xmoshte/nielo/docs/pics&3d/nielo_fv.png

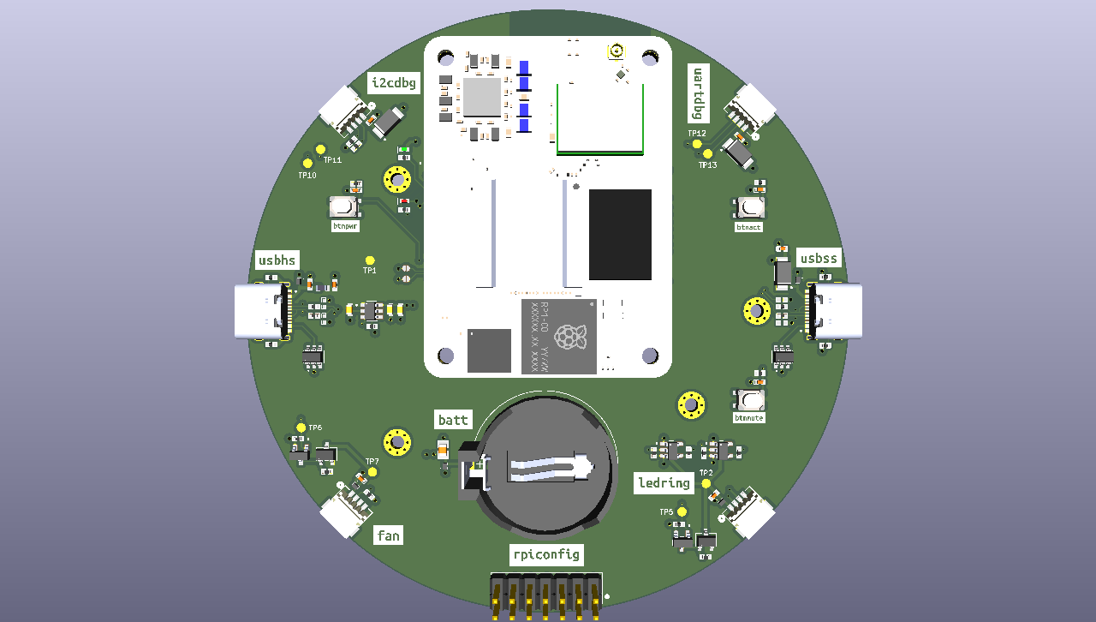
docs/pics&3d/nielo_fv.png
