xmoshte/nielo/docs/pics&3d/nielo_bv.png

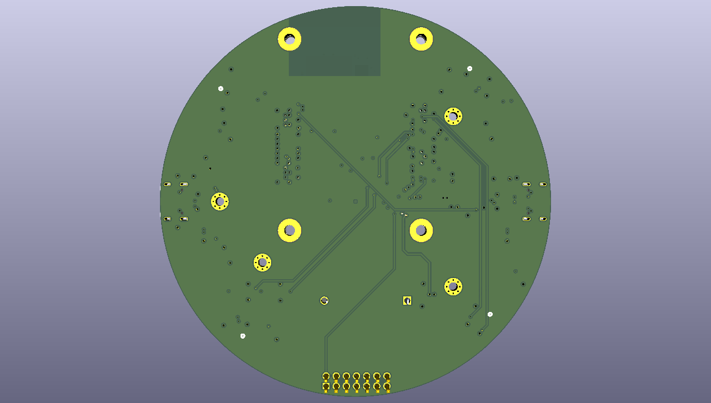
docs/pics&3d/nielo_bv.png
