xmoshte/nielo/docs/pics&3d/nielo.step

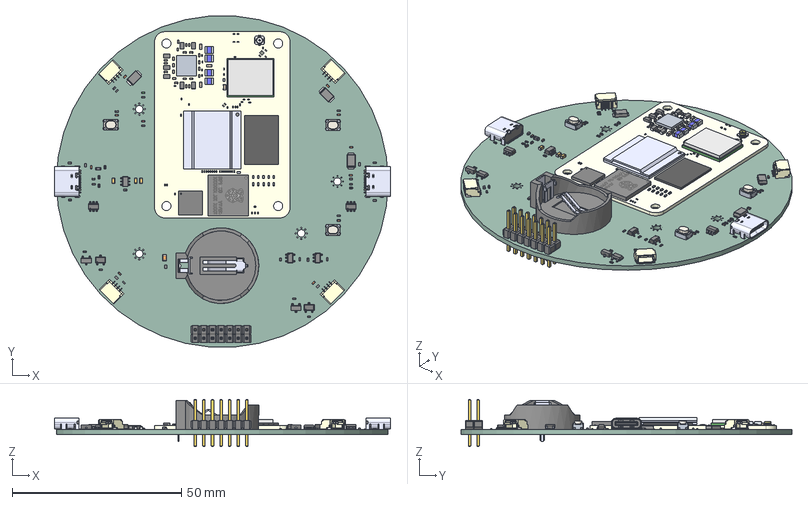
[picture p3: CAD file, 2026-09-26]
docs/pics&3d/nielo.step
99.3 x 97.7 x 14.0 mm
User Library-0402(1005M) Cap x 14
PESD5V5C1BLYL x 5
User Library-res0402-1 x 25
TYPE-C-31-M-12 x 2
PTS815SJM250SMTRLFS_PART1 x 3
PTS815SJM250SMTRLFS_PART2 x 3
PTS815SJM250SMTRLFS_PART3_2 x 3
PTS815SJM250SMTRLFS_PART3 x 3
PTS815SJM250SMTRLFS_PART3_1 x 3
PTS815SJM250SMTRLFS_PART3_4 x 3
PTS815SJM250SMTRLFS_PART3_3 x 3
200-ball_VFBGAold.step
CAP0201.step x 190
RES0201old.step x 71
CAP0402.step x 81
PMIC STEP.STEP
3D-SRP201208-R47MH-20230512 .step x 7
term2 x 4
term1 x 4
2712 v2 STEP.STEP
CAP0603.step x 10
RES0402.step x 10
SOT883B Mold body x 4
SOT883B4 LF x 4
User Library-SKY13351-378LF.step
ProjectY v3 STEP.STEP
(Unsaved)
PinIndicator
Pads x 2
Lid x 2
Plating
LDF
CPD
Pins
User Library-153BallWFBGA
10164228-1001A1RLF.stp x 2
ABM11-0022-T3.step x 2
DIELECTRIC_Model_1_Inst
User Library-Chip Capacitor2 x 3
SM04B-SRSS-TB(LF)(SN) x 4
User Library-led_0402 x 2
2N7002_2N7002 x 2
SMA6S56AH MWG x 3
DBV5 x 2
BS-7
SW3dPS-0805 SMD Capacitor
AP22653W6-7
nie1CBC_PCB
