xmoshte/nielo/docs/schematics/nielo.pdf

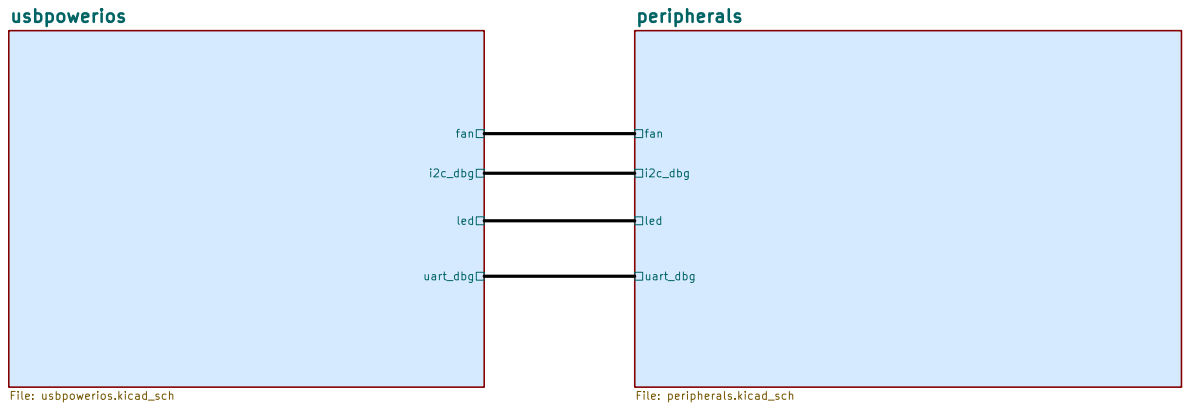
[picture p4: page 1]

Size: A4 | Rev:
KiCad E.D.A. 10.0.5 | Id: 1/3

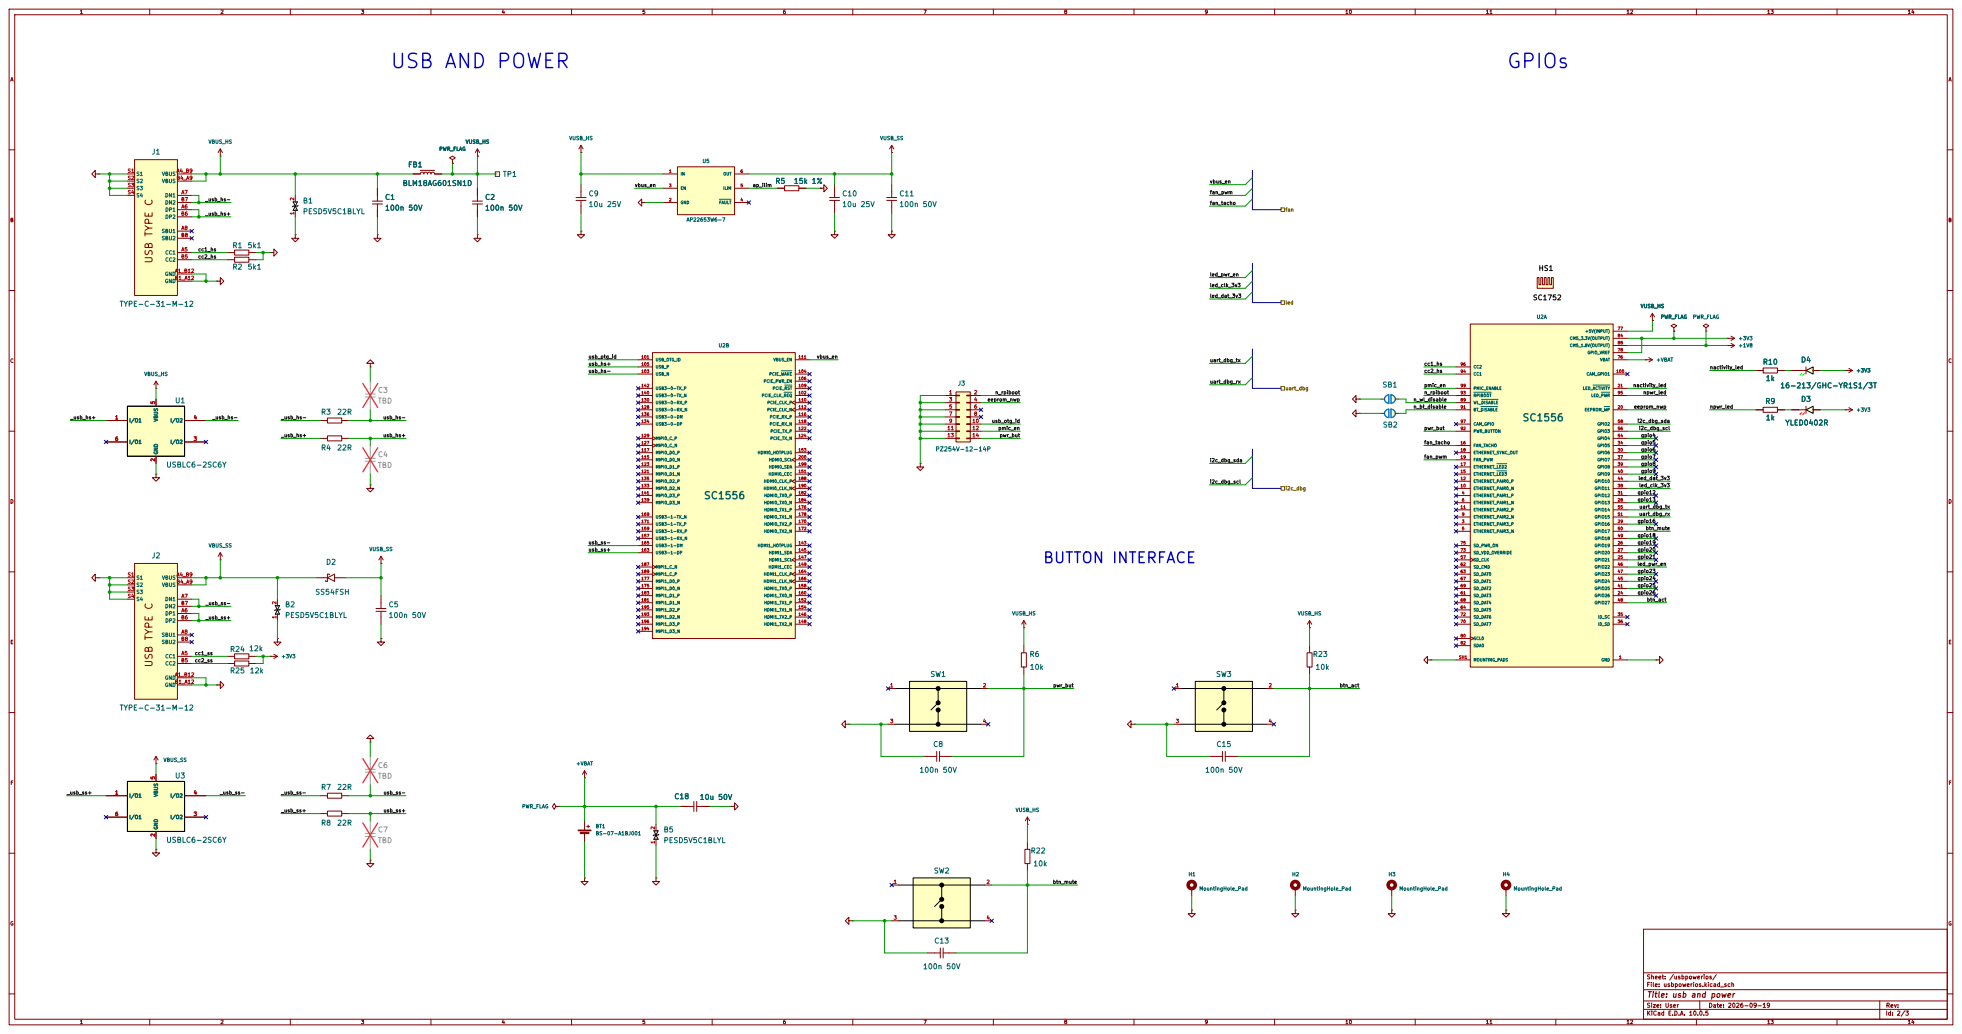
[picture p5: page 2]

11 | 12 pmic_en
13 | 14

Sheet: /usbpowerios/
File: usbpowerios.kicad_sch
Title: usb and power

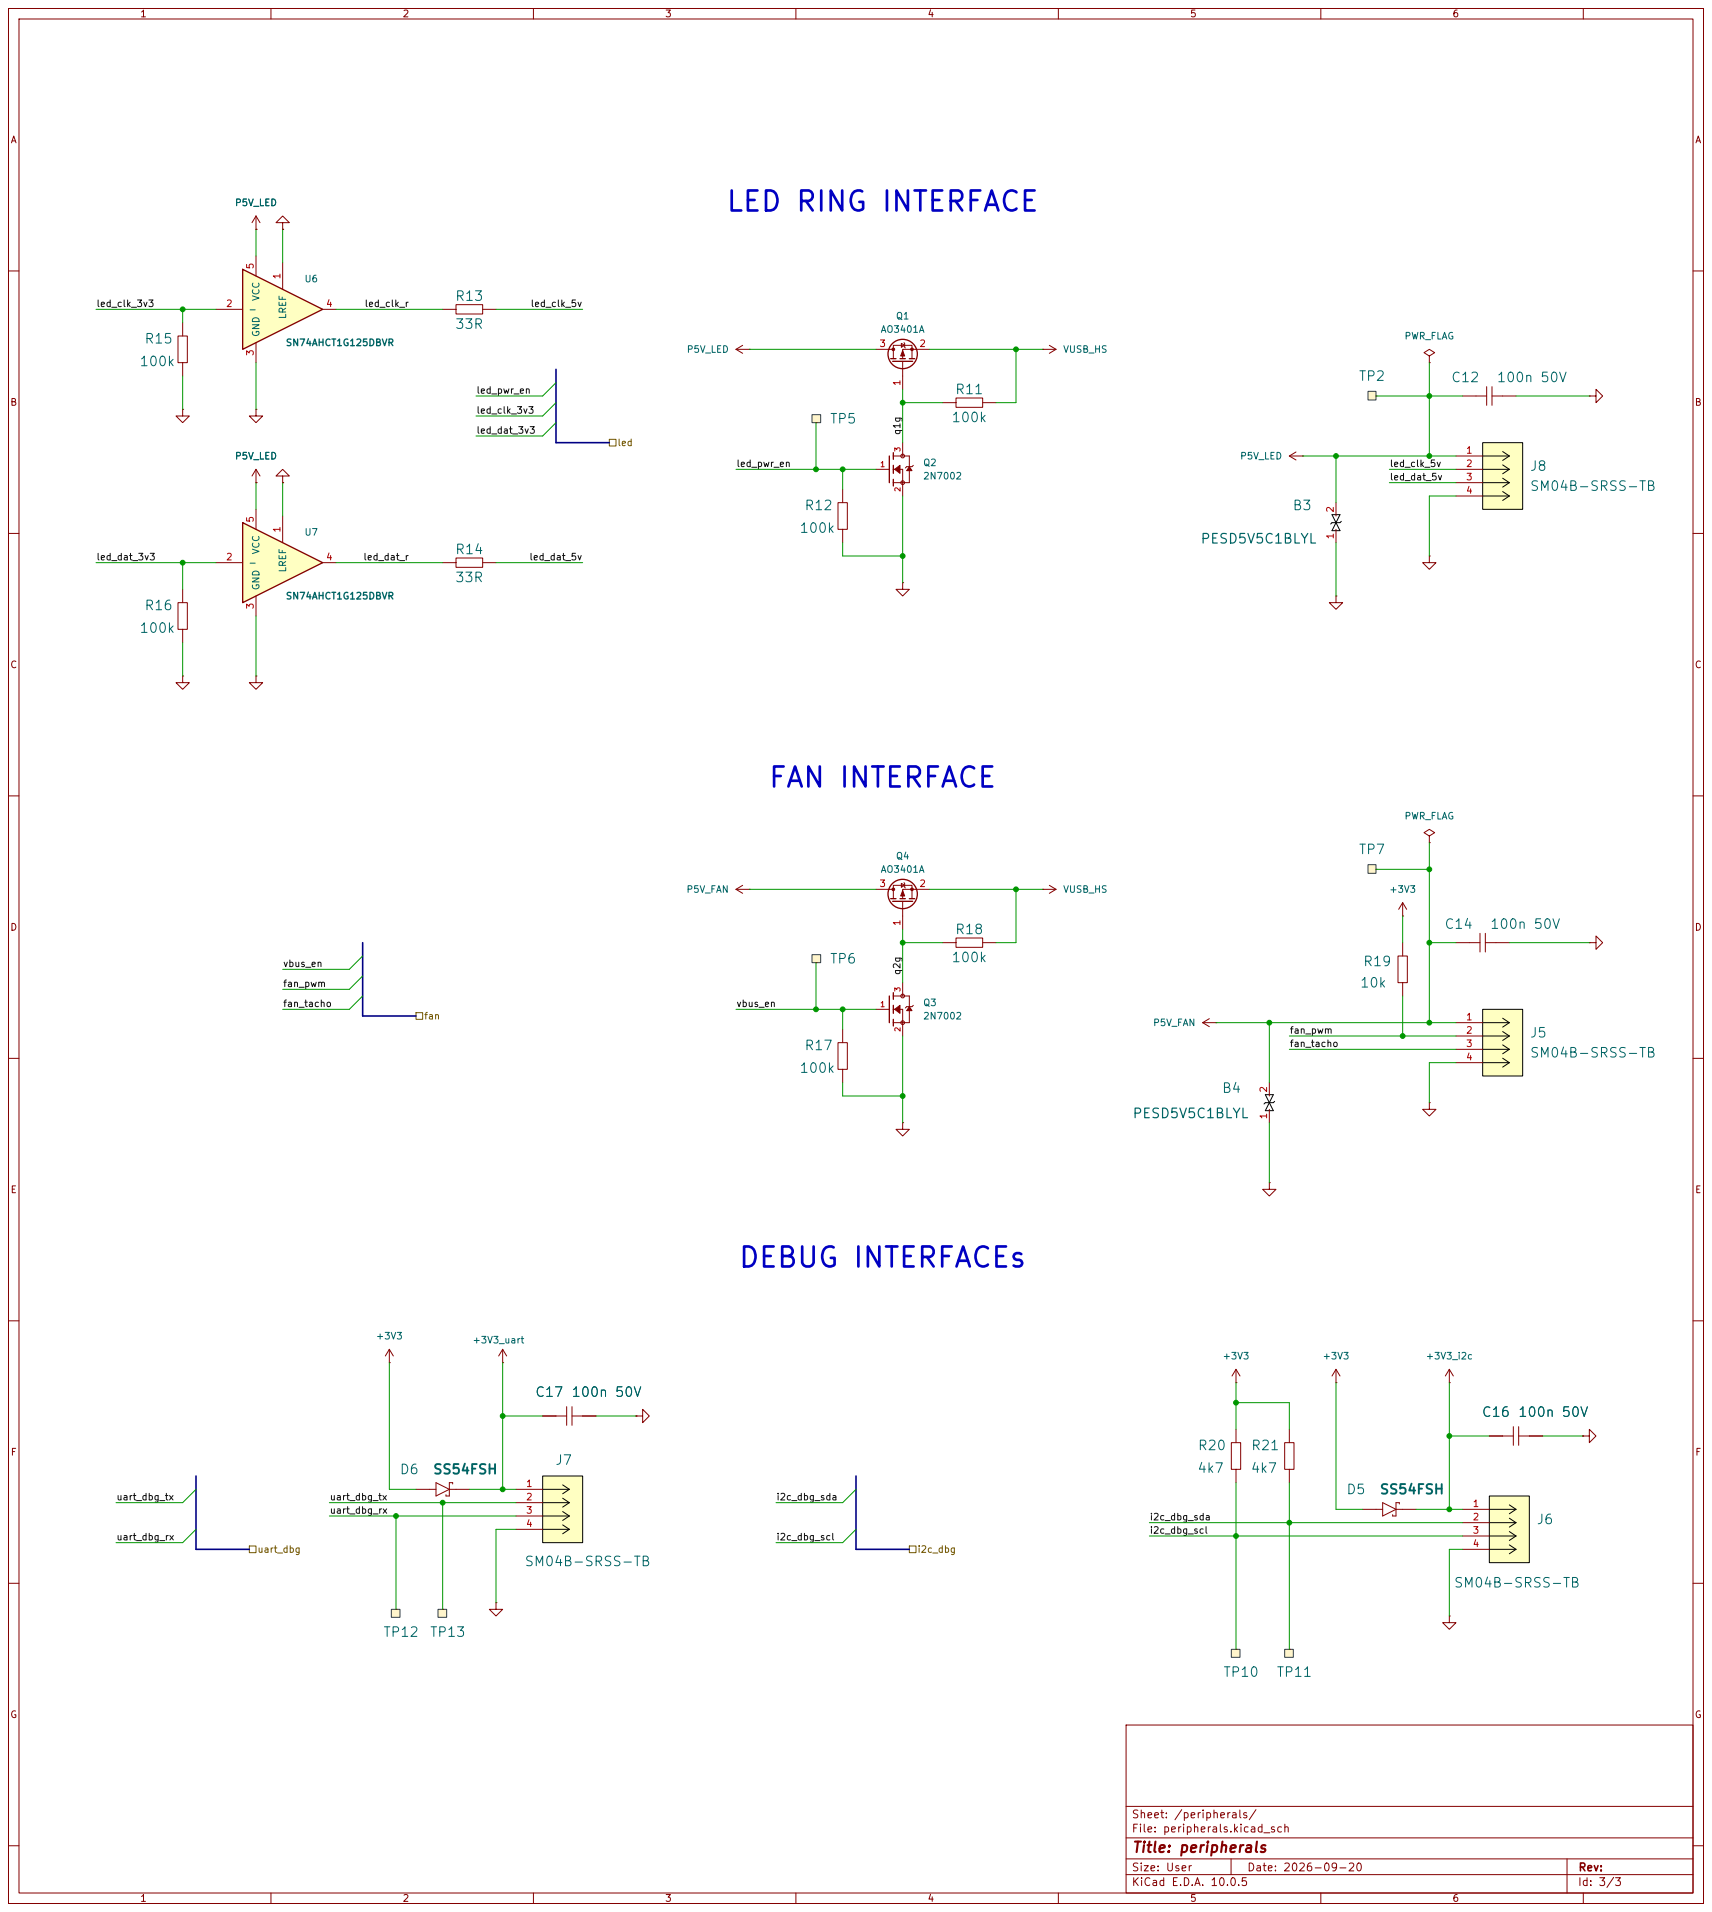
[picture p6: page 3]
