xmoshte/nielo/source/nielo.kicad_pcb

## KiCad design source/nielo.kicad_pcb (2026-09-26)

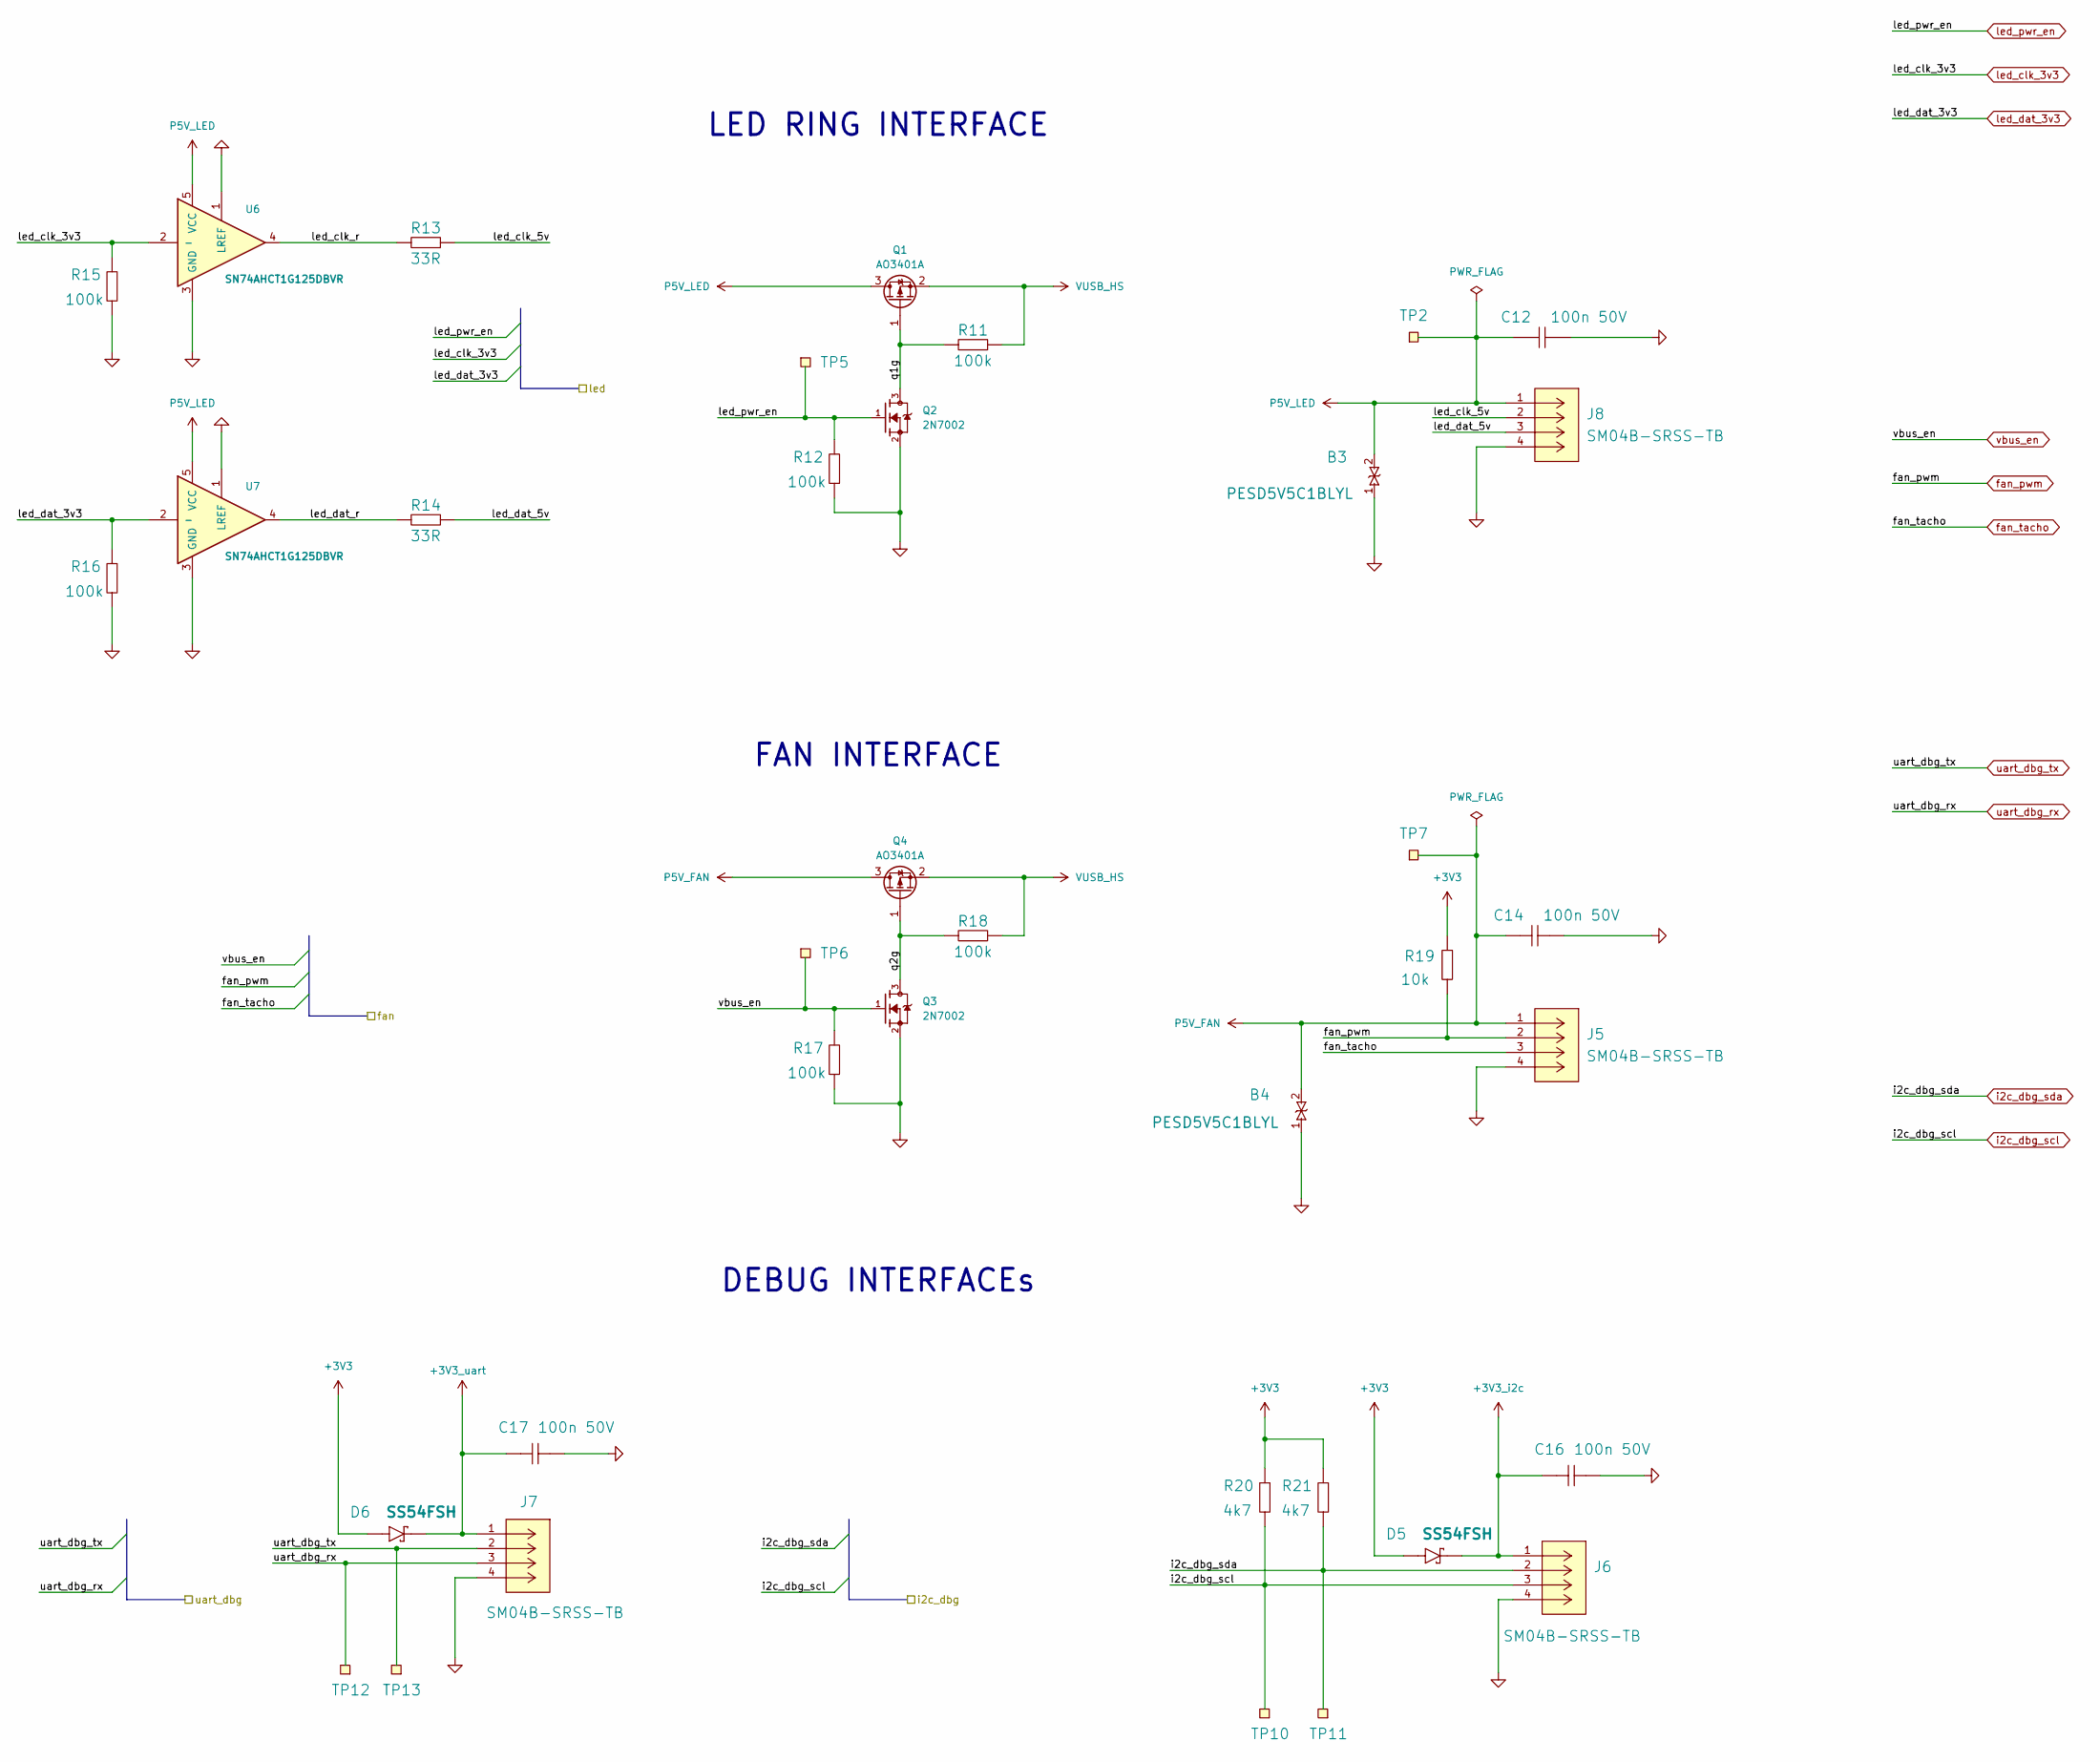
[picture p7: schematic peripherals.kicad_sch]

Parts:
B3, B4: PESD5V5C1BLYL; MPN PESD5V5C1BLYL; LCSC No C18212174
C12, C14, C16, C17: 100n 50V; CAPC1005X04L; MPN 04025C104JAT2A; DigiKey No 478-KGM05CR71H104JHTR-ND
D5, D6: SS54FSH; SODFL4725X110N; MPN SS54FSH; LCSC No C19855357
J5, J6, J7, J8: SM04B-SRSS-TB; CONN_SM04B-SRSS-TB_JST; MPN SM04B-SRSS-TB; Mouser No 306-SM04BSRSSTBLFSN
Q1, Q4: AO3401A; SOT-23-3L_AOS; MPN AO3401A; DigiKey No 785-1001-2-ND
Q2, Q3: 2N7002; SOT95P240X111-3N; MPN 2N7002; Mouser No 512-2N7002
R11, R12, R15, R16, R17, R18: 100k; RESC1005X04L; MPN CR0402-JW-104GLF; LCSC No C203104
R13, R14: 33R; RESC1005X04L; MPN MCS0402MC3309FE000; LCSC No C2074234
R19: 10k; RESC1005X04L; MPN MCS0402MD1002BE500; LCSC No C2073498
R20, R21: 4k7; RESC1005X04L; MPN RCA04024K70FKED; LCSC No C1858949
TP2, TP5, TP6, TP7, TP10, TP11, TP12, TP13: TP_SMD_D1.5mm
U6, U7: SN74AHCT1G125DBVR; SOT95P280X145-5N; MPN SN74AHCT1G125DBVR; Mouser No 595-SNAHCT1G125DBVR

Connections:
+3V3: D5.A, D6.A, R19.2, R20.2, R21.2; also elsewhere on the board
+3V3_i2c: C16.2, D5.C (K), J6.1
+3V3_uart: C17.2, D6.C (K), J7.1
/peripherals/led_clk_5v: J8.2, R13.2
/peripherals/led_clk_r: R13.1, U6.4
/peripherals/led_dat_5v: J8.3, R14.2
/peripherals/led_dat_r: R14.1, U7.4
/peripherals/q1g: Q1.1 (G), Q2.3, R11.1
/peripherals/q2g: Q3.3, Q4.1 (G), R18.1
GND: B3.1 (K1), B4.1 (K1), C12.1, C14.1, C16.1, C17.1, J5.4, J6.4, J7.4, J8.4, Q2.2, Q3.2, R12.1, R15.1, R16.1, R17.1, U6.1 (LREF), U6.3 (GND), U7.1 (LREF), U7.3 (GND); also elsewhere on the board
P5V_FAN: B4.2 (K2), C14.2, J5.1, Q4.3 (D), TP7.1 (1_1)
P5V_LED: B3.2 (K2), C12.2, J8.1, Q1.3 (D), TP2.1 (1_1), U6.5 (VCC), U7.5 (VCC)
VUSB_HS: Q1.2 (S), Q4.2 (S), R11.2, R18.2; also elsewhere on the board
fan_pwm: J5.2, R19.1; also elsewhere on the board
fan_tacho: J5.3; also elsewhere on the board
i2c_dbg_scl: J6.3, R20.1, TP10.1 (1_1); also elsewhere on the board
i2c_dbg_sda: J6.2, R21.1, TP11.1 (1_1); also elsewhere on the board
led_clk_3v3: R15.2, U6.2 (-); also elsewhere on the board
led_dat_3v3: R16.2, U7.2 (-); also elsewhere on the board
led_pwr_en: Q2.1, R12.2, TP5.1 (1_1); also elsewhere on the board
uart_dbg_rx: J7.3, TP12.1 (1_1); also elsewhere on the board
uart_dbg_tx: J7.2, TP13.1 (1_1); also elsewhere on the board
vbus_en: Q3.1, R17.2, TP6.1 (1_1); also elsewhere on the board

Notes on the sheet:
LED RING INTERFACE
DEBUG INTERFACEs
FAN INTERFACE

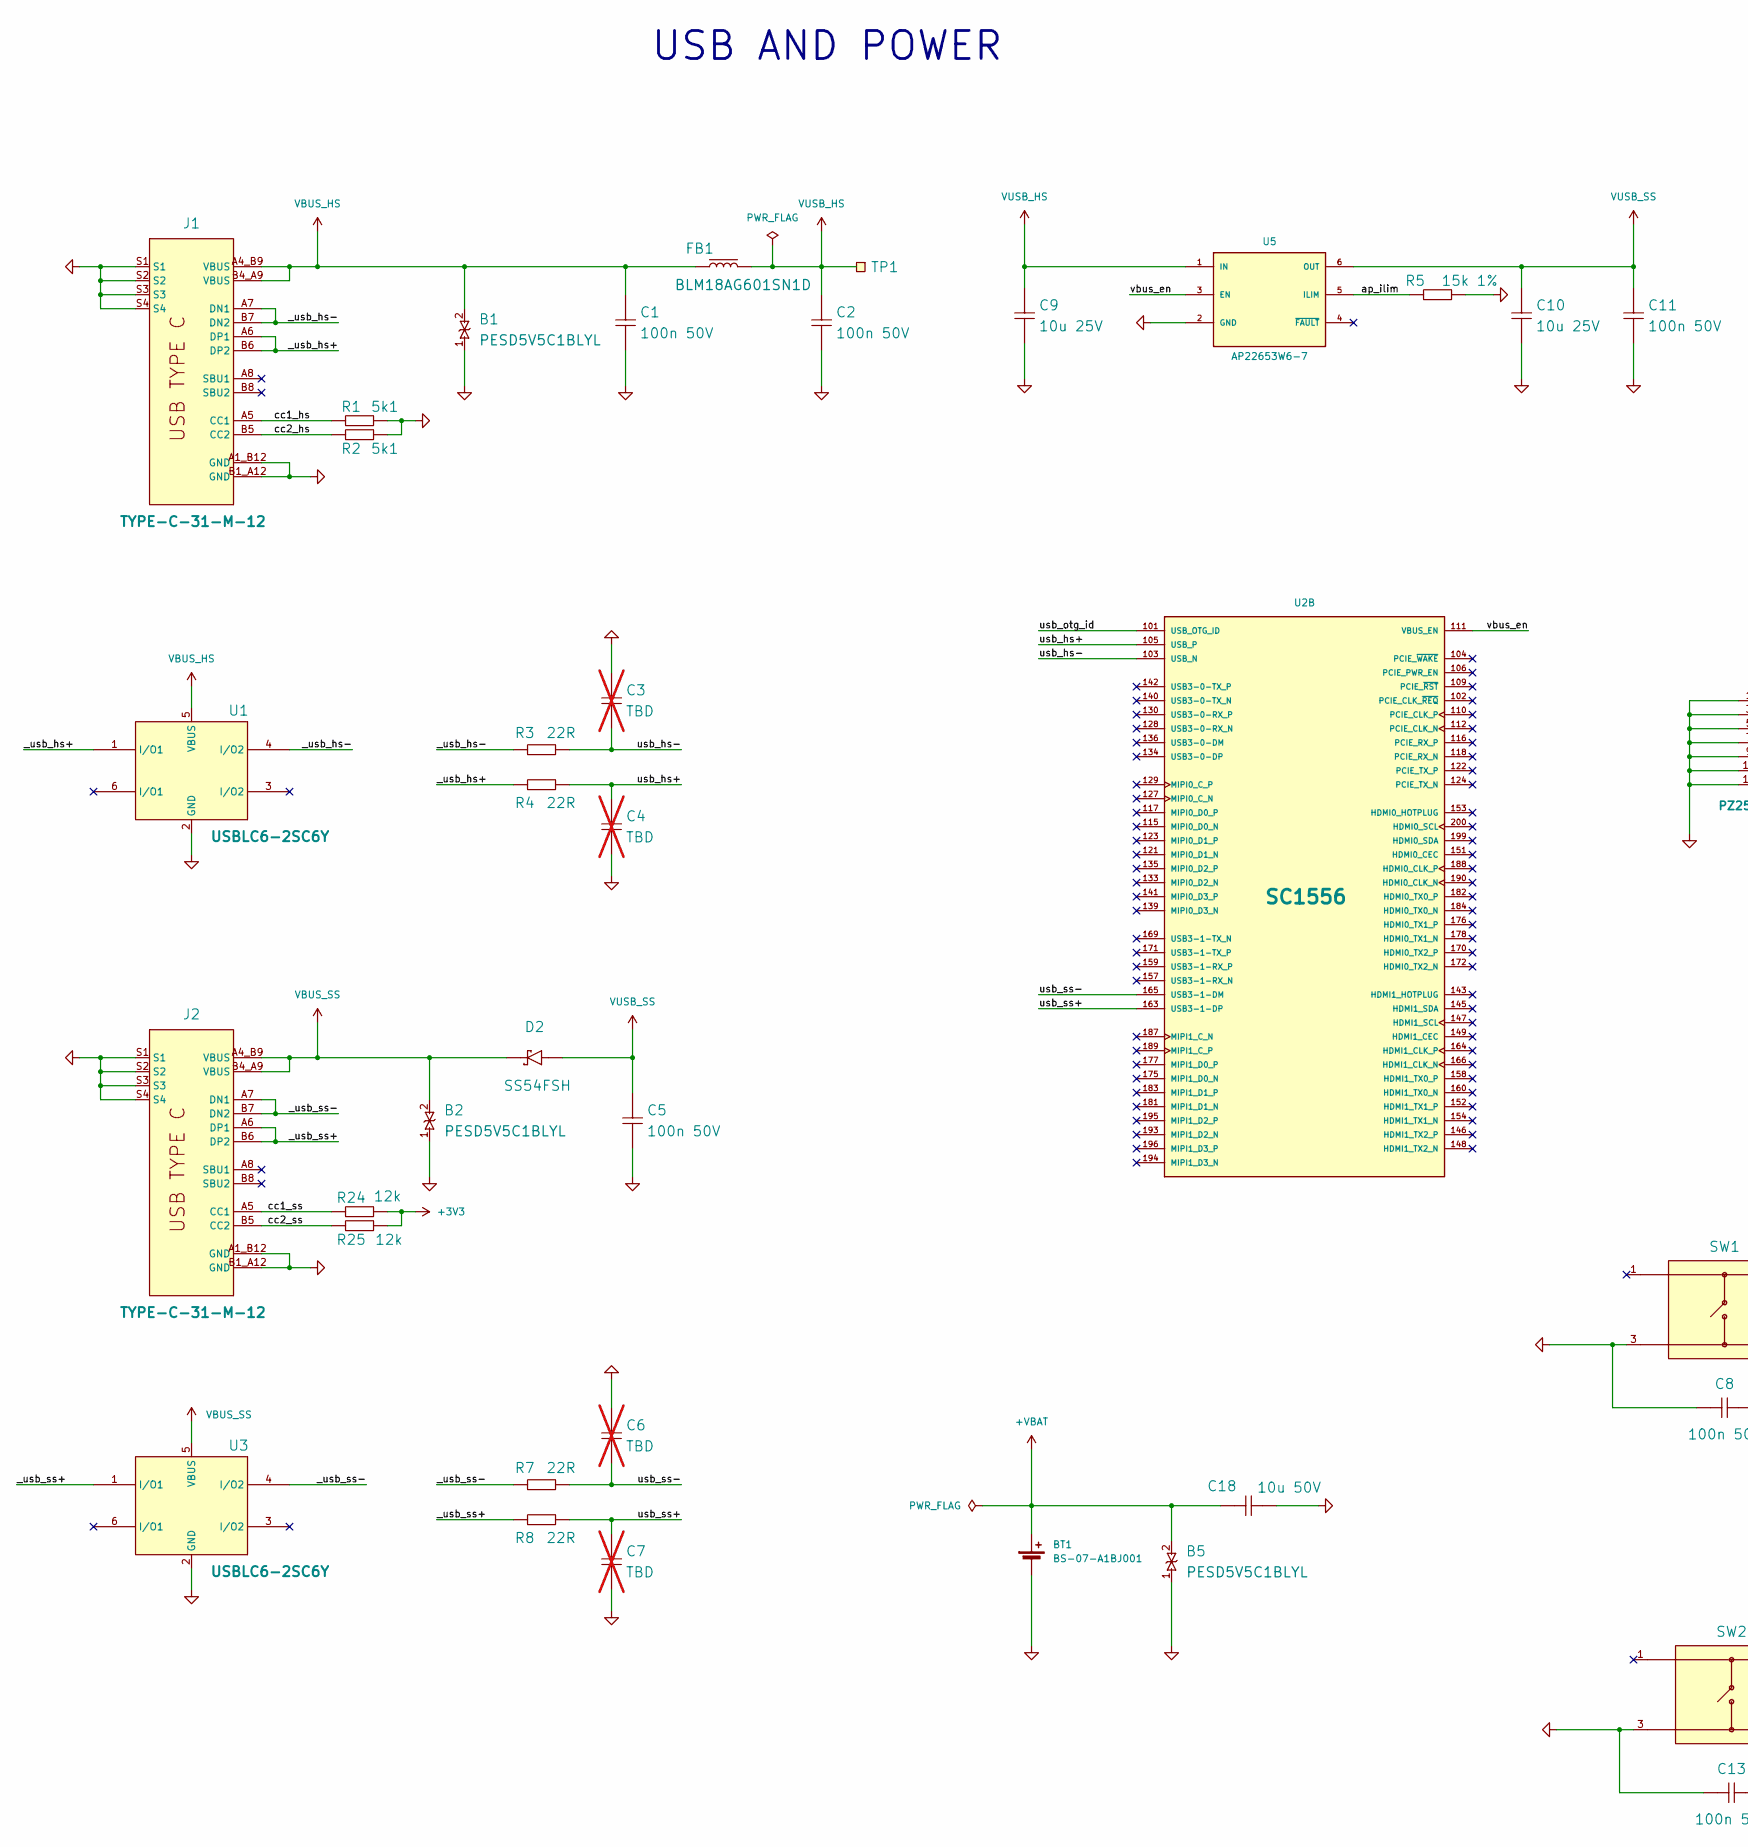
[picture p8: schematic usbpowerios.kicad_sch, usb and power, part in row 1, column 1]

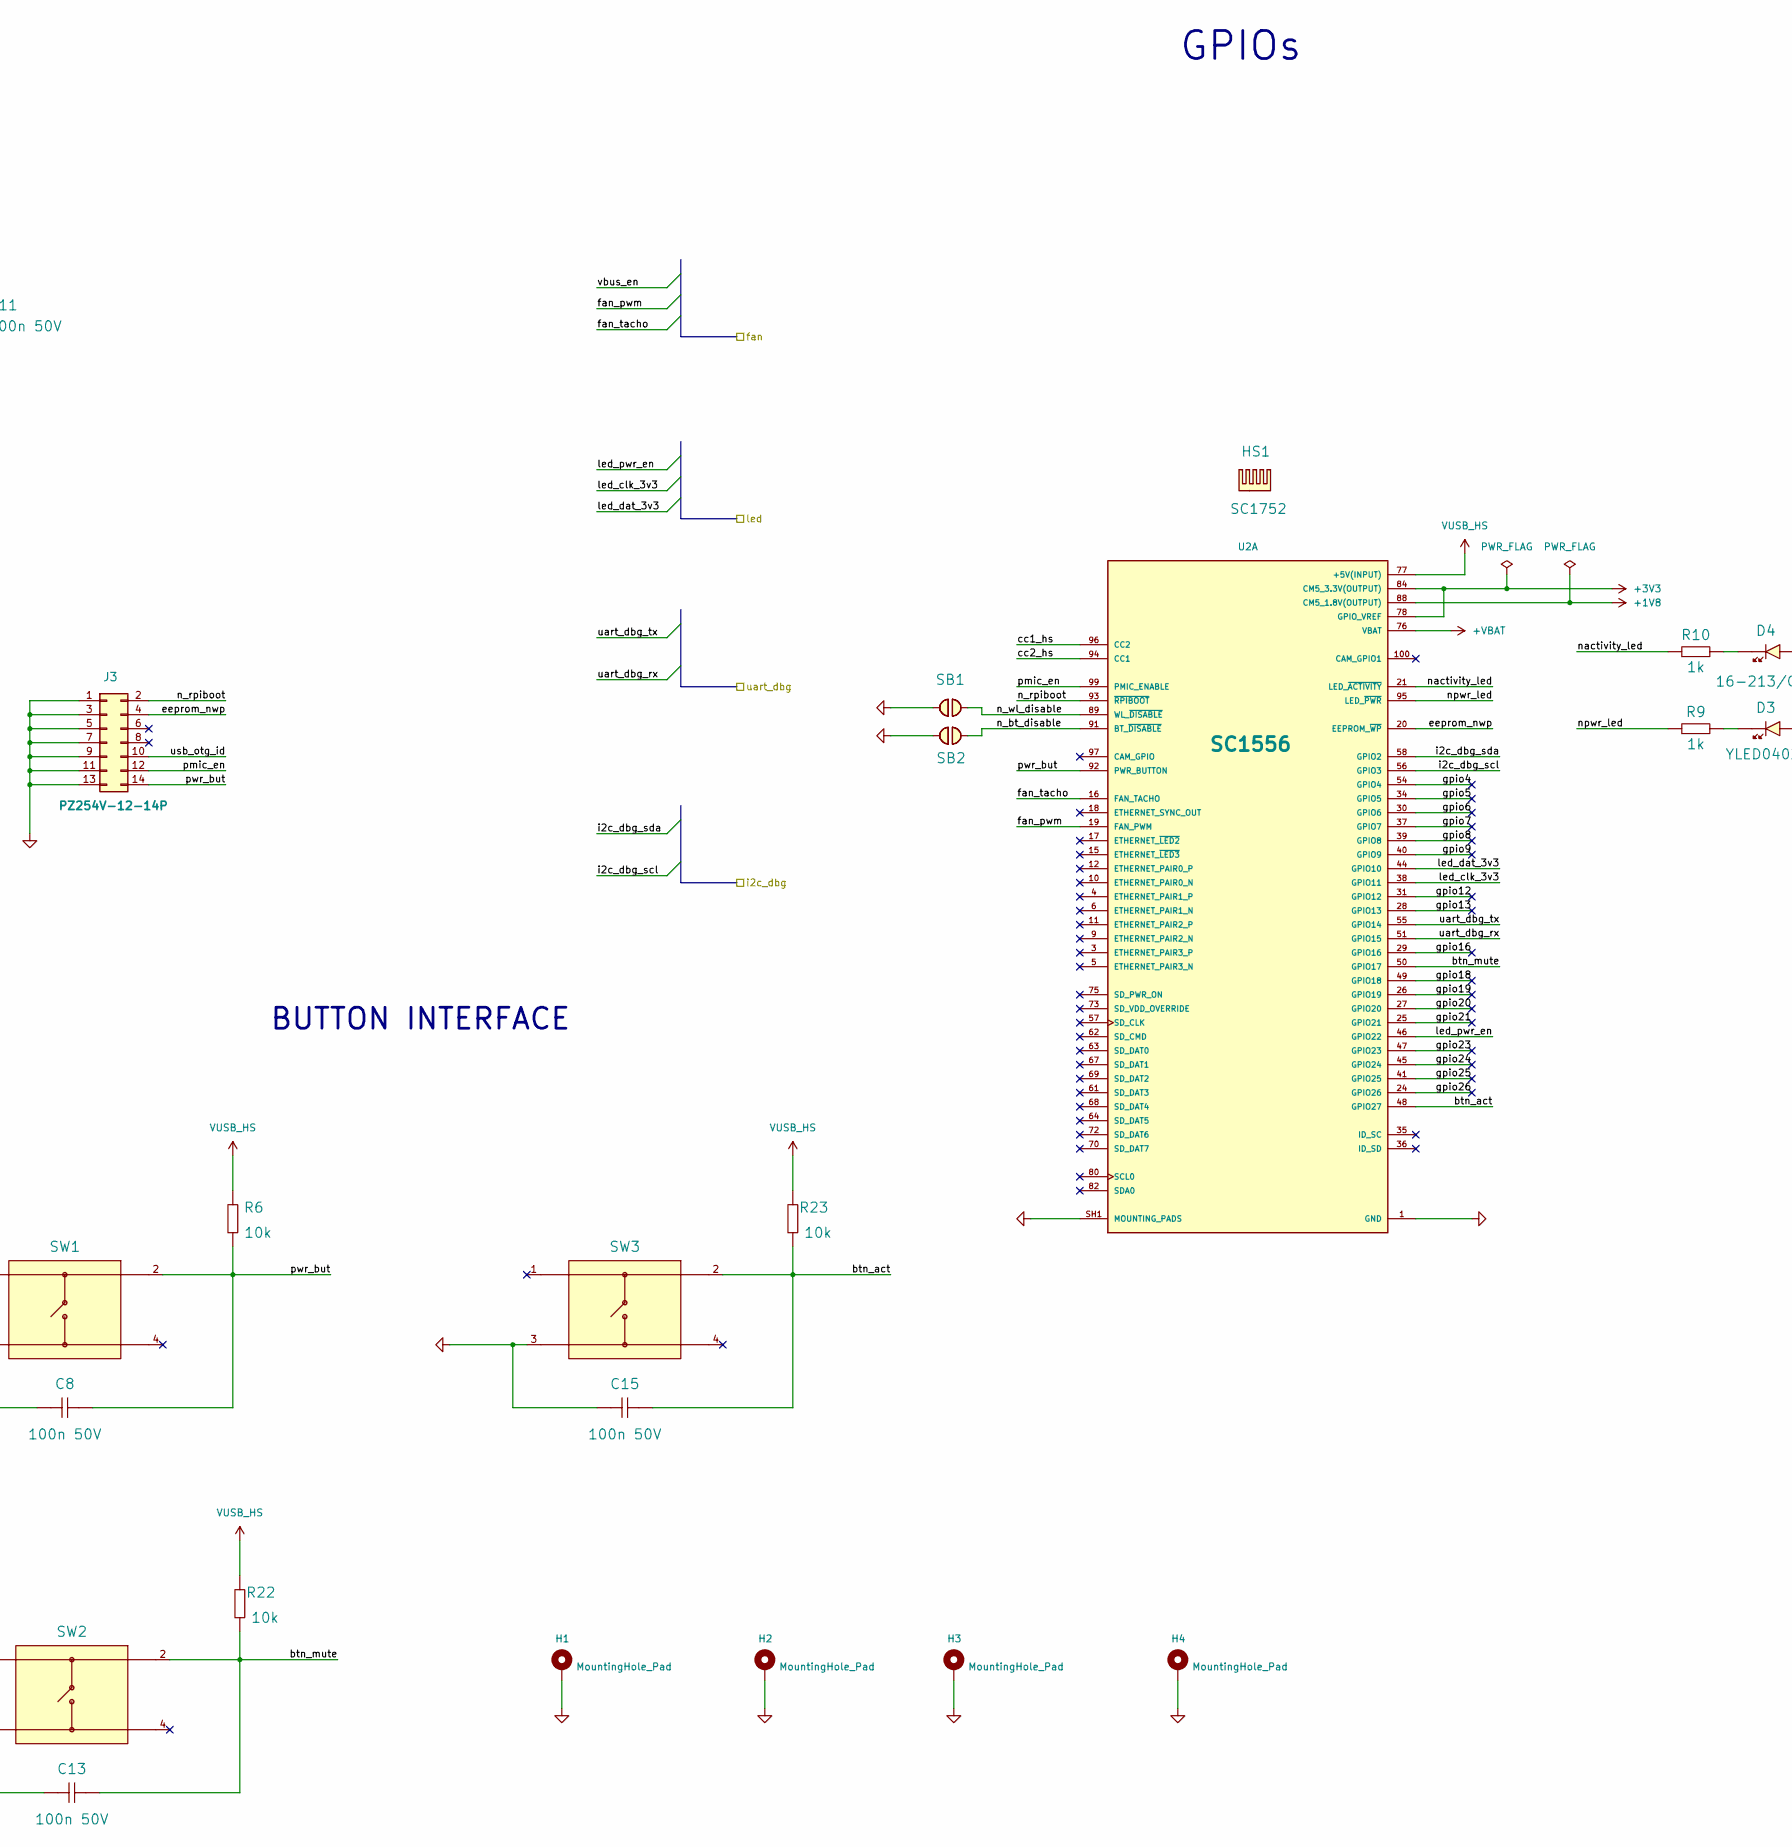
[picture p9: schematic usbpowerios.kicad_sch, usb and power, part in row 1, column 2]

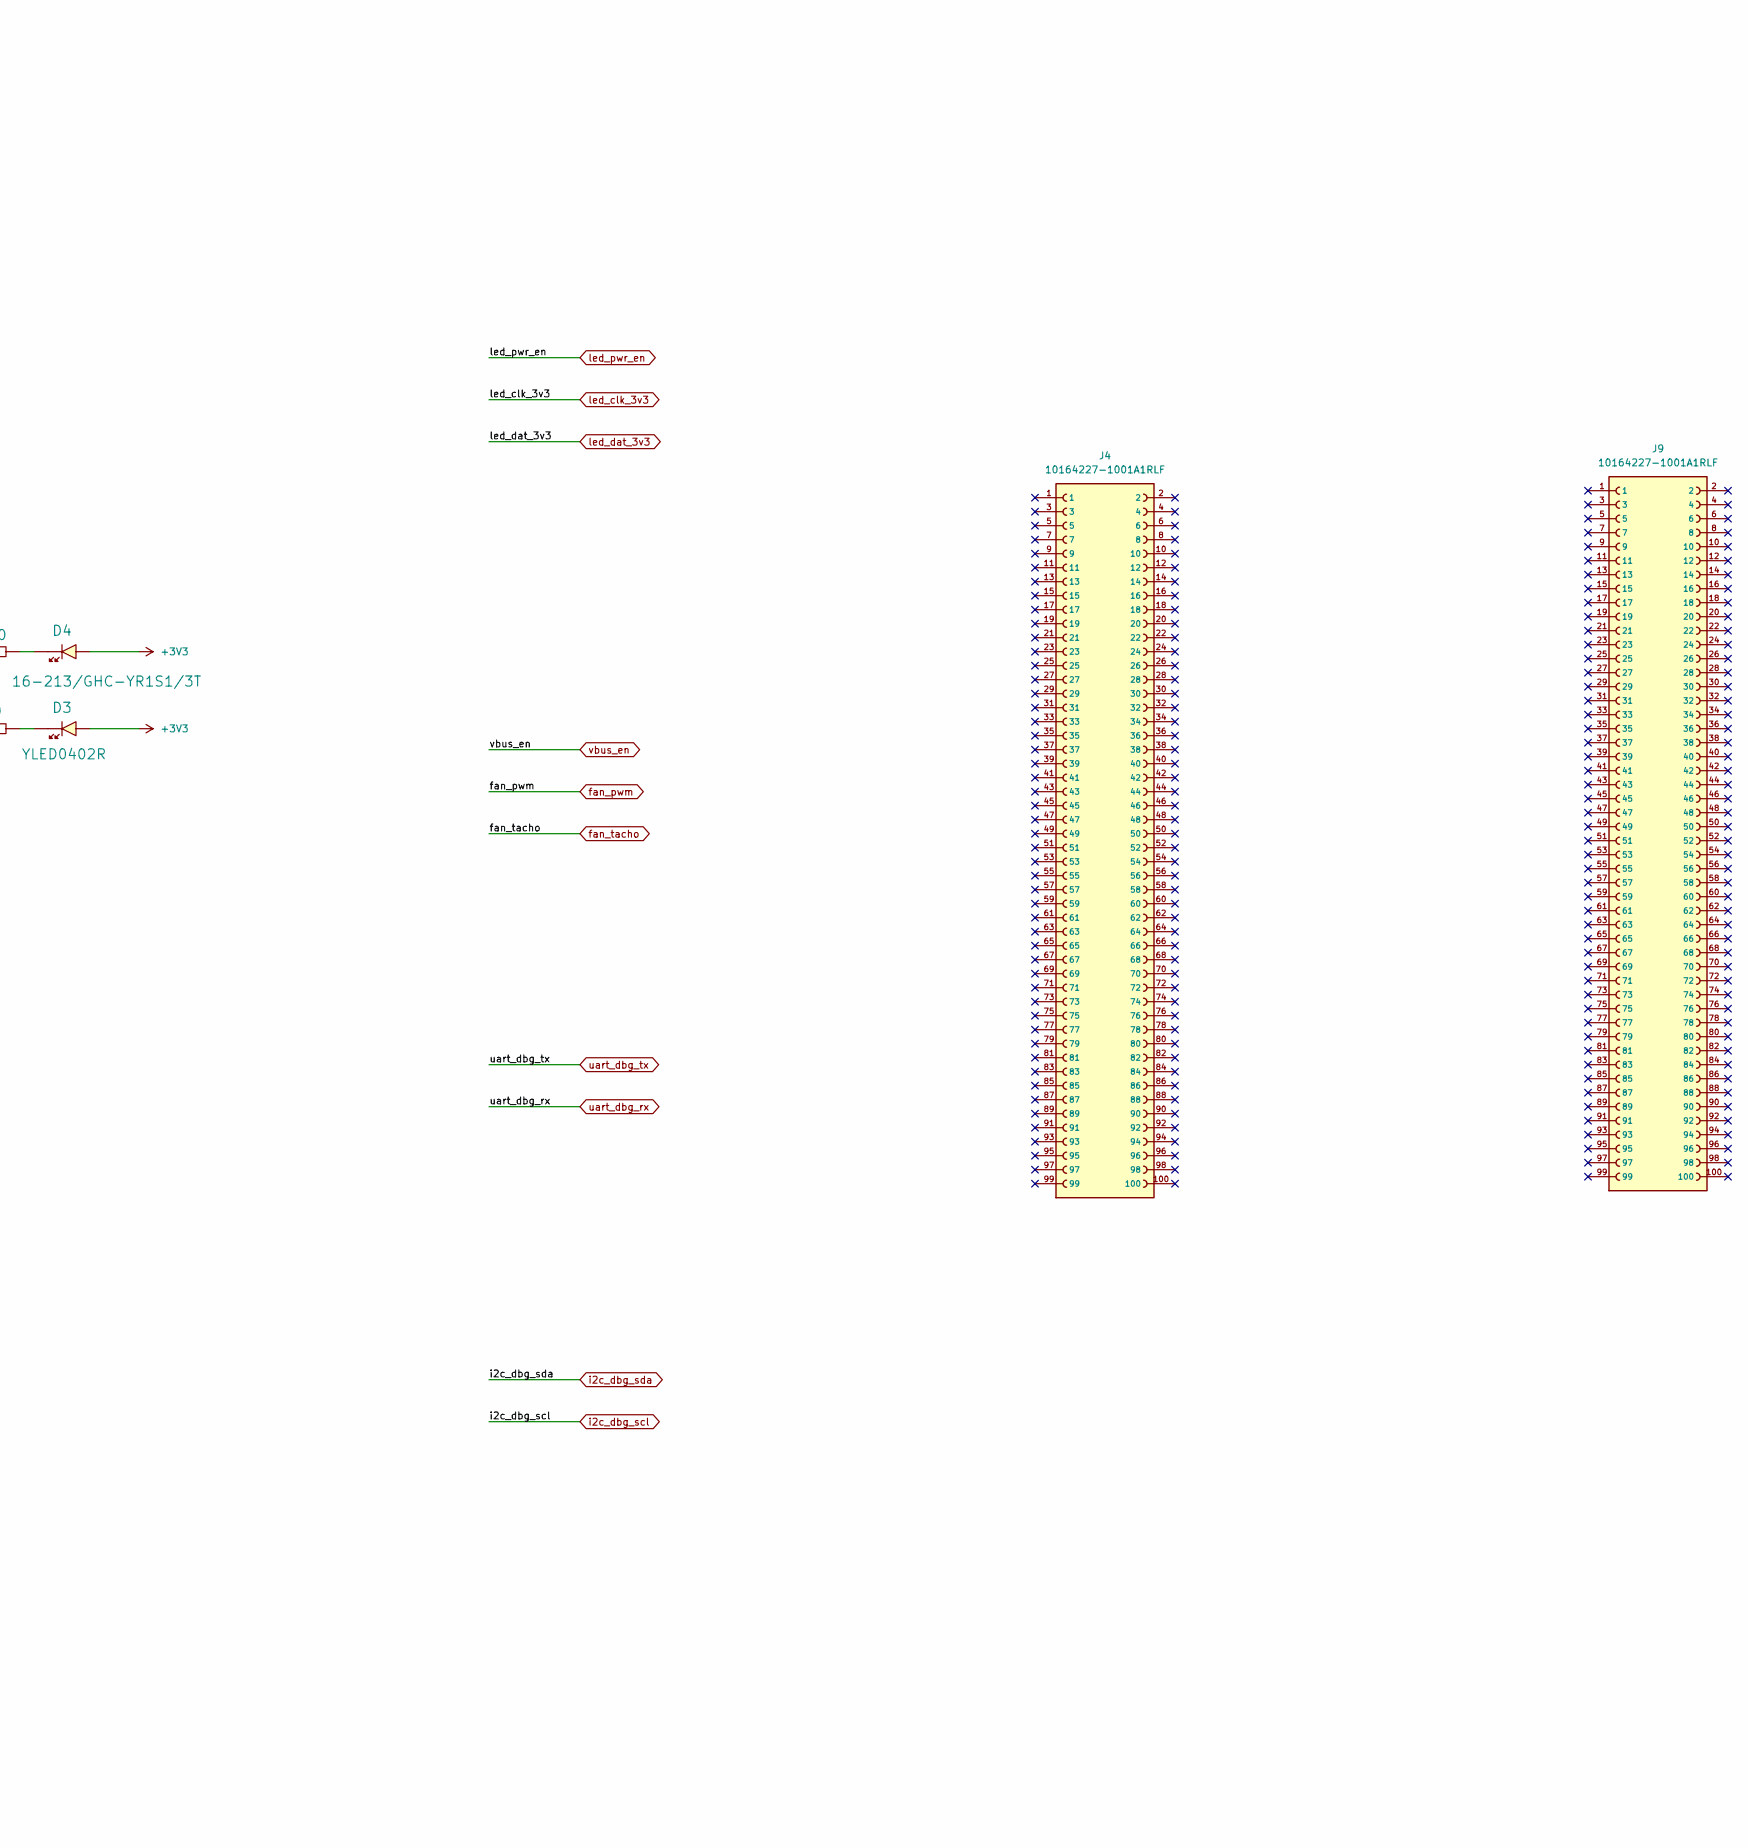
[picture p10: schematic usbpowerios.kicad_sch, usb and power, part in row 1, column 3]

Parts:
B1, B2, B5: PESD5V5C1BLYL; MPN PESD5V5C1BLYL; LCSC No C18212174
BT1: BS-07-A1BJ001; BatteryHolder_MYOUNG_BS-07-A1BJ001_CR2032; MPN BS-07-A1BJ001; LCSC No C2979167
C1, C2, C5, C8, C13, C15: 100n 50V; CAPC1005X04L; MPN 04025C104JAT2A; DigiKey No 478-KGM05CR71H104JHTR-ND
C3, C4, C6, C7: TBD; CAPC1005X04L; MPN TBD; not fitted
C9, C10: 10u 25V; CAPC1608X06L; MPN CC0603KRX5R8BB106; DigiKey No 13-CC0603KRX5R8BB106TR-ND
C11: 100n 50V; CAPC1608X06L; MPN CML0603X7R104KT50V; DigiKey No 738-CML0603X7R104KT50VTR-ND
C18: 10u 50V; CAPC2012X11L; MPN KGM21FS61E106KU; DigiKey No 478-KGM21FS61E106KUTR-ND
D2: SS54FSH; SODFL4725X110N; MPN SS54FSH; LCSC No C19855357
D3: YLED0402R; LED_0402_RED; MPN YLED0402R; LCSC No C21260817
D4: 16-213/GHC-YR1S1/3T; LED_0402_GREEN; MPN 16-213/GHC-YR1S1/3T; LCSC No C74338
FB1: BLM18AG601SN1D; FB_0603; MPN BLM18AG601SN1D; LCSC No C19330
H1, H2, H3, H4: MountingHole_Pad; MountingHole_2.2mm_M2_Pad_Via
HS1: SC1752; MPN SC1752; Mouser No 358-SC1752
J1, J2: TYPE-C-31-M-12; HRO_TYPE-C-31-M-12; MPN TYPE-C-31-M-12; LCSC No C165948
J3: PZ254V-12-14P; MPN PZ254V-12-14P; LCSC No C492424
J4, J9: 10164227-1001A1RLF; MPN 10164227-1001A1RLF; Mouser No 649-01642271001A1RLF
R1, R2: 5k1; RESC1005X04L; MPN TNPW04025K10BEED; LCSC No C2088796
R3, R4, R7, R8: 22R; RESC1005X04L; MPN CR0402-JW-220GLF; LCSC No C2076445
R5: 15k 1%; RESC1005X04L; MPN MCS04020C1502FE500; LCSC No C2074222
R6, R22, R23: 10k; RESC1005X04L; MPN MCS0402MD1002BE500; LCSC No C2073498
R9, R10: 1k; RESC1005X04L; MPN CRCW04021K65FKEE; LCSC No C2076615
R24, R25: 12k; RESC1005X04L; MPN CR0402-FX-1202GLF; LCSC No C2085429
SB1, SB2: solderbridge; Solderbridge
SW1, SW2, SW3: Tactile Switch; PTS815; MPN PTS815SJM250SMTRLFS; LCSC No C2689510
TP1: TP_SMD_D1.5mm
U1, U3: USBLC6-2SC6Y; SOT23-6L_STM; MPN USBLC6-2SC6Y; LCSC No C2969755
U2: SC1556; MODULE_CM5002000; MPN SC1556; Mouser No 358-SC1556
U5: AP22653W6-7; SOT95P280X145-6N; MPN AP22653W6-7; Mouser No 621-AP22653W6-7

Connections:
+1V8: U2.88 (CM5_1.8V(OUTPUT)), U2.90 (CM5_1.8V(OUTPUT))
+3V3: D3.A, D4.A, R24.2, R25.2, U2.78 (GPIO_VREF), U2.84 (CM5_3.3V(OUTPUT)), U2.86 (CM5_3.3V(OUTPUT)); also elsewhere on the board
+VBAT: B5.2 (K2), BT1.1 (+), C18.1, U2.76 (VBAT)
/usbpowerios/_usb_hs+: J1.A6 (DP1), J1.B6 (DP2), R4.1, U1.1 (I/O1)
/usbpowerios/_usb_hs-: J1.A7 (DN1), J1.B7 (DN2), R3.1, U1.4 (I/O2)
/usbpowerios/_usb_ss+: J2.A6 (DP1), J2.B6 (DP2), R8.1, U3.1 (I/O1)
/usbpowerios/_usb_ss-: J2.A7 (DN1), J2.B7 (DN2), R7.1, U3.4 (I/O2)
/usbpowerios/ap_ilim: R5.1, U5.5 (ILIM)
/usbpowerios/btn_act: C15.1, R23.1, SW3.2, U2.48 (GPIO27)
/usbpowerios/btn_mute: C13.1, R22.1, SW2.2, U2.50 (GPIO17)
/usbpowerios/cc1_hs: J1.A5 (CC1), R1.1, U2.96 (CC2)
/usbpowerios/cc1_ss: J2.A5 (CC1), R24.1
/usbpowerios/cc2_hs: J1.B5 (CC2), R2.1, U2.94 (CC1)
/usbpowerios/cc2_ss: J2.B5 (CC2), R25.1
/usbpowerios/eeprom_nwp: J3.4, U2.20 (EEPROM_~WP)
/usbpowerios/gpio4: U2.54 (GPIO4)
/usbpowerios/gpio5: U2.34 (GPIO5)
/usbpowerios/gpio6: U2.30 (GPIO6)
/usbpowerios/gpio7: U2.37 (GPIO7)
/usbpowerios/gpio8: U2.39 (GPIO8)
/usbpowerios/gpio9: U2.40 (GPIO9)
/usbpowerios/gpio12: U2.31 (GPIO12)
/usbpowerios/gpio13: U2.28 (GPIO13)
/usbpowerios/gpio16: U2.29 (GPIO16)
/usbpowerios/gpio18: U2.49 (GPIO18)
/usbpowerios/gpio19: U2.26 (GPIO19)
/usbpowerios/gpio20: U2.27 (GPIO20)
/usbpowerios/gpio21: U2.25 (GPIO21)
/usbpowerios/gpio23: U2.47 (GPIO23)
/usbpowerios/gpio24: U2.45 (GPIO24)
/usbpowerios/gpio25: U2.41 (GPIO25)
/usbpowerios/gpio26: U2.24 (GPIO26)
/usbpowerios/n_bt_disable: SB2.1 (0), U2.91 (BT_~DISABLE)
/usbpowerios/n_rpiboot: J3.2, U2.93 (~RPIBOOT)
/usbpowerios/n_wl_disable: SB1.1 (0), U2.89 (WL_~DISABLE)
/usbpowerios/nactivity_led: R10.2, U2.21 (LED_~ACTIVITY)
/usbpowerios/npwr_led: R9.2, U2.95 (LED_~PWR)
/usbpowerios/pmic_en: J3.12, U2.99 (PMIC_ENABLE)
/usbpowerios/pwr_but: C8.1, J3.14, R6.1, SW1.2, U2.92 (PWR_BUTTON)
/usbpowerios/usb_hs+: C4.2, R4.2, U2.105 (USB_P)
/usbpowerios/usb_hs-: C3.1, R3.2, U2.103 (USB_N)
/usbpowerios/usb_otg_id: J3.10, U2.101 (USB_OTG_ID)
/usbpowerios/usb_ss+: C7.2, R8.2, U2.163 (USB3-1-DP)
/usbpowerios/usb_ss-: C6.1, R7.2, U2.165 (USB3-1-DM)
GND: B1.1 (K1), B2.1 (K1), B5.1 (K1), BT1.2 (-), C1.1, C2.1, C3.2, C4.1, C5.1, C6.2, C7.1, C8.2, C9.1, C10.1, C11.1, C13.2, C15.2, C18.2, H1.1 (1_1), H2.1 (1_1), H3.1 (1_1), H4.1 (1_1), J1.A1_B12 (GND), J1.B1_A12 (GND), J1.S1, J1.S2, J1.S3, J1.S4, J2.A1_B12 (GND), J2.B1_A12 (GND), J2.S1, J2.S2, J2.S3, J2.S4, J3.1, J3.3, J3.5, J3.7, J3.9, J3.11, J3.13, R1.2, R2.2, R5.2, SB1.2 (1), SB2.2 (1), SW1.3, SW2.3, SW3.3, U1.2 (GND), U2.1 (GND), U2.2 (GND), U2.7 (GND), U2.8 (GND), U2.13 (GND), U2.14 (GND), U2.22 (GND), U2.23 (GND), U2.32 (GND), U2.33 (GND), U2.42 (GND), U2.43 (GND), U2.52 (GND), U2.53 (GND), U2.59 (GND), U2.60 (GND), U2.65 (GND), U2.66 (GND), U2.71 (GND), U2.74 (GND), U2.98 (GND), U2.107 (GND), U2.108 (GND), U2.113 (GND), U2.114 (GND), U2.119 (GND), U2.120 (GND), U2.125 (GND), U2.126 (GND), U2.131 (GND), U2.132 (GND), U2.137 (GND), U2.138 (GND), U2.144 (GND), U2.150 (GND), U2.155 (GND), U2.156 (GND), U2.161 (GND), U2.162 (GND), U2.167 (GND), U2.168 (GND), U2.173 (GND), U2.174 (GND), U2.179 (GND), U2.180 (GND), U2.185 (GND), U2.186 (GND), U2.191 (GND), U2.192 (GND), U2.197 (GND), U2.198 (GND), U2.SH1 (MOUNTING_PADS), U2.SH2 (MOUNTING_PADS), U2.SH3 (MOUNTING_PADS), U2.SH4 (MOUNTING_PADS), U3.2 (GND), U5.2 (GND); also elsewhere on the board
unnamed: D3.K, R9.1
unnamed: D4.K, R10.1
VBUS_HS: B1.2 (K2), C1.2, FB1.1, J1.A4_B9 (VBUS), J1.B4_A9 (VBUS), U1.5 (VBUS)
VBUS_SS: B2.2 (K2), D2.C (K), J2.A4_B9 (VBUS), J2.B4_A9 (VBUS), U3.5 (VBUS)
VUSB_HS: C2.2, C9.2, FB1.2, R6.2, R22.2, R23.2, TP1.1 (1_1), U2.77 (+5V(INPUT)), U2.79 (+5V(INPUT)), U2.81 (+5V(INPUT)), U2.83 (+5V(INPUT)), U2.85 (+5V(INPUT)), U2.87 (+5V(INPUT)), U5.1 (IN); also elsewhere on the board
VUSB_SS: C5.2, C10.2, C11.2, D2.A, U5.6 (OUT)
fan_pwm: U2.19 (FAN_PWM); also elsewhere on the board
fan_tacho: U2.16 (FAN_TACHO); also elsewhere on the board
i2c_dbg_scl: U2.56 (GPIO3); also elsewhere on the board
i2c_dbg_sda: U2.58 (GPIO2); also elsewhere on the board
led_clk_3v3: U2.38 (GPIO11); also elsewhere on the board
led_dat_3v3: U2.44 (GPIO10); also elsewhere on the board
led_pwr_en: U2.46 (GPIO22); also elsewhere on the board
uart_dbg_rx: U2.51 (GPIO15); also elsewhere on the board
uart_dbg_tx: U2.55 (GPIO14); also elsewhere on the board
vbus_en: U2.111 (VBUS_EN), U5.3 (EN); also elsewhere on the board

Notes on the sheet:
GPIOs
BUTTON INTERFACE
USB AND POWER

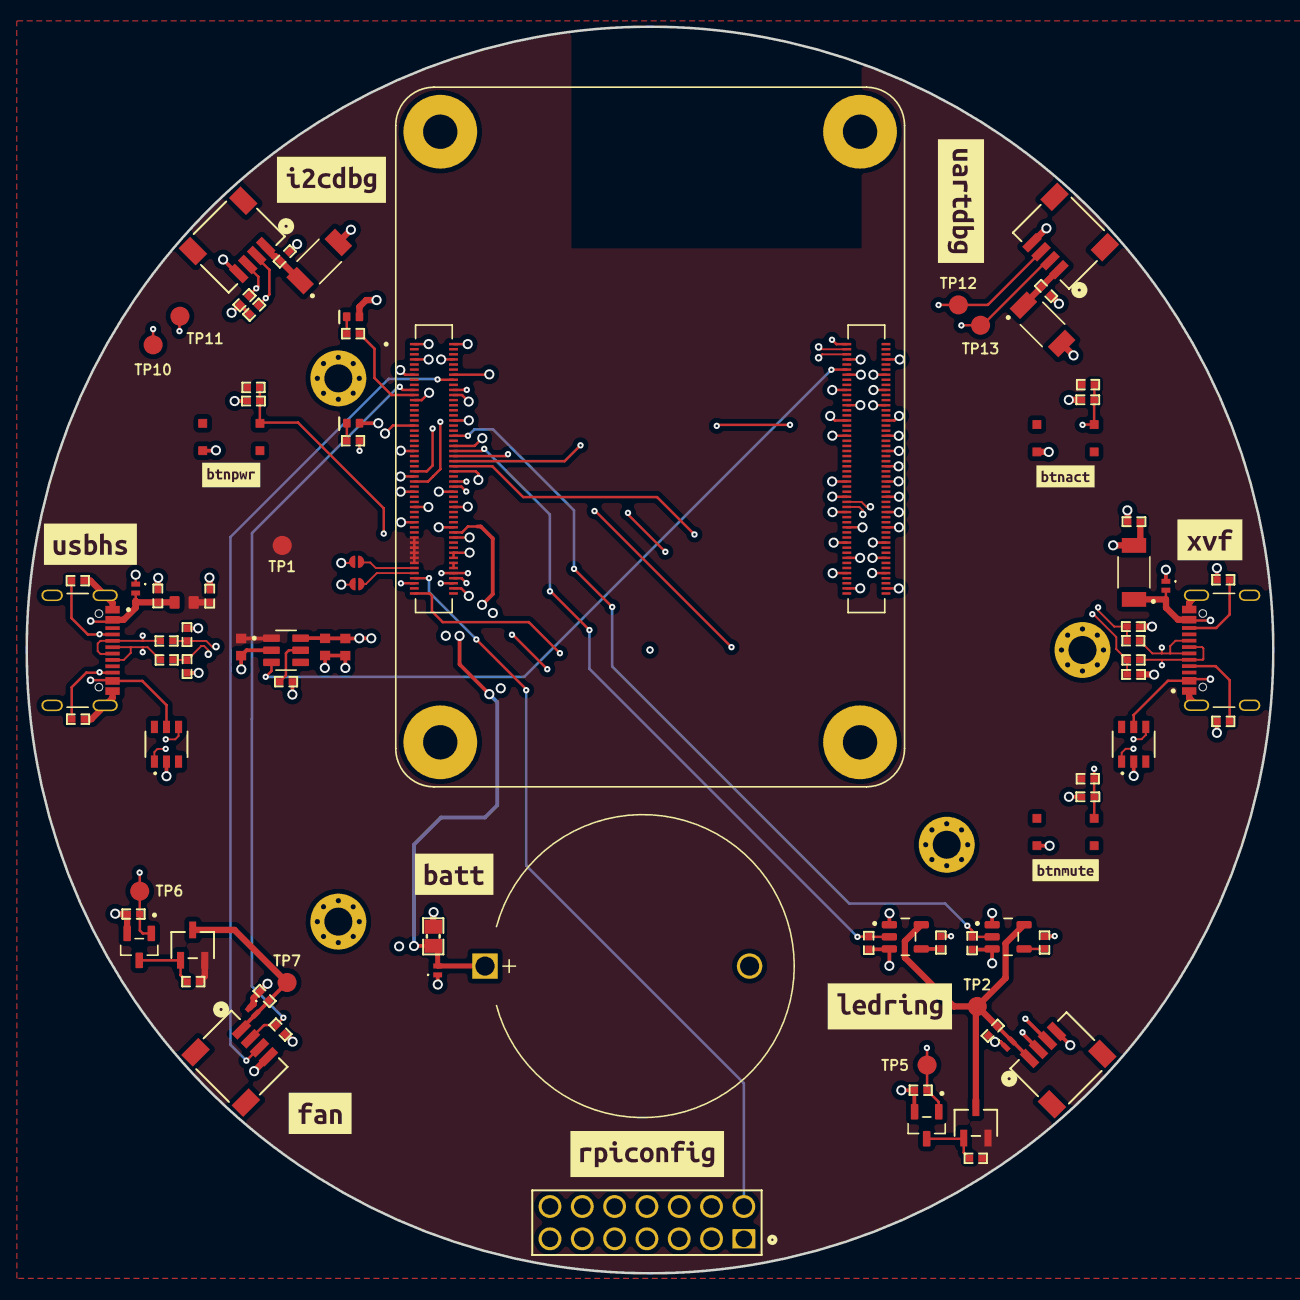
[picture p11: board nielo.kicad_pcb from above]

Board: 6 copper layers, 98.0 x 98.0 mm, 101 parts (1 on the bottom side), 54 nets.

Other parts of the board:
kibuzzard-6AB7D9C9: G***; kibuzzard-6AB7D9C9
kibuzzard-6AB23A8A: G***; kibuzzard-6AB23A8A
kibuzzard-6AB23B9E: G***; kibuzzard-6AB23B9E
kibuzzard-6AB23B67: G***; kibuzzard-6AB23B67
kibuzzard-6AB23B87: G***; kibuzzard-6AB23B87
kibuzzard-6AB23BC6: G***; kibuzzard-6AB23BC6
kibuzzard-6AB23BDC: G***; kibuzzard-6AB23BDC
kibuzzard-6AB23C12: G***; kibuzzard-6AB23C12
kibuzzard-6AB23C23: G***; kibuzzard-6AB23C23
kibuzzard-6AB23C57: G***; kibuzzard-6AB23C57
kibuzzard-6AB24C6E: G***; kibuzzard-6AB24C6E
