xmoshte/nielo/(commit log)

2026-09-20 Battery holder remaining
    [nielo.kicad_pcb, nielo.kicad_sch, peripherals.kicad_sch, usbpowerios.kicad_sch]
2026-09-20 usb&power -> usbpowerios
    [nielo.kicad_sch]
2026-09-20 schematics r1 done, awaiting verification
    [bom.csv, nielo.kicad_sch, peripherals.kicad_sch, usbpowerios.kicad_sch]
2026-09-20 rpi description
    [bom.csv, usbpowerios.kicad_sch]
2026-09-22 layout done, awaiting verification
    [nielo.kicad_pcb, peripherals.kicad_sch, usbpowerios.kicad_sch]
2026-09-22 usb pair routed
    [nielo.kicad_pcb]
2026-09-25 mounting holes flash
    [nielo.kicad_pcb, peripherals.kicad_sch, usbpowerios.kicad_sch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]
2026-09-26 manufactering files & step files added
    [bom.csv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]
2026-09-26 usbss pull-up resistors 10k-->12k
    [nielo.kicad_pcb, usbpowerios.kicad_sch]
2026-09-26 manufactering files r2
    [bom.csv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]
